mbrennwa/osmcdoc/figures/osmc_cabinet_open_damping.pdf

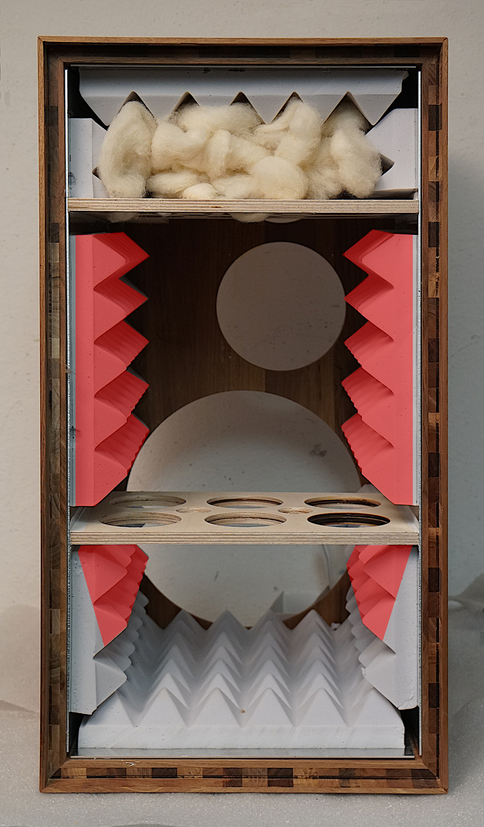
[picture p18: page 1]
