mbrennwa/osmcdoc/plots/osmc_analysis/data_filter_transfer_EL20190303/lowpass_inductor_positions.png

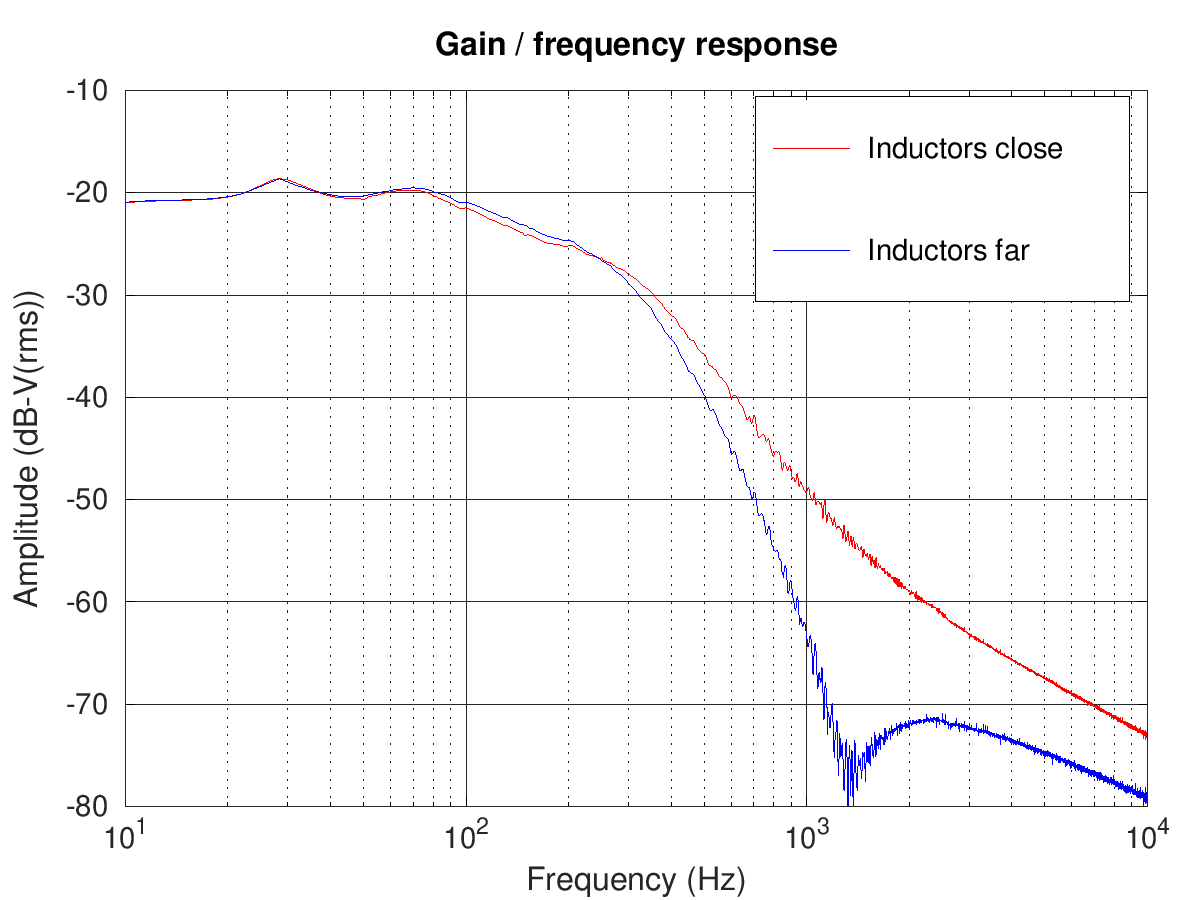
plots/osmc_analysis/data_filter_transfer_EL20190303/lowpass_inductor_positions.png
