mbrennwa/osmcdoc/plots/osmc_analysis/data_outdoor/outdoor_20181227/acoustic_mid.png

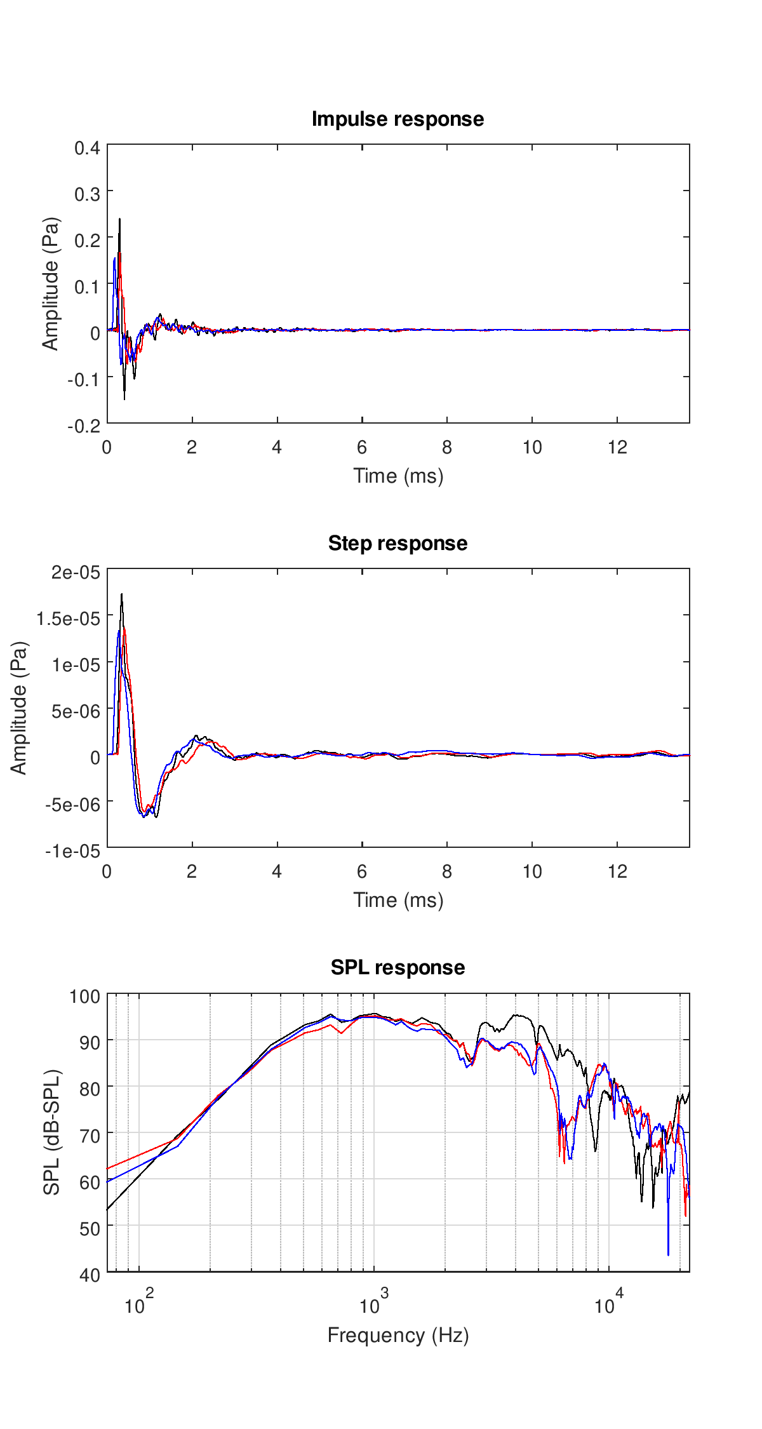
plots/osmc_analysis/data_outdoor/outdoor_20181227/acoustic_mid.png
