mbrennwa/osmcdoc/plots/osmc_analysis/data_outdoor/outdoor_20181227/acoustic_tweeter.png

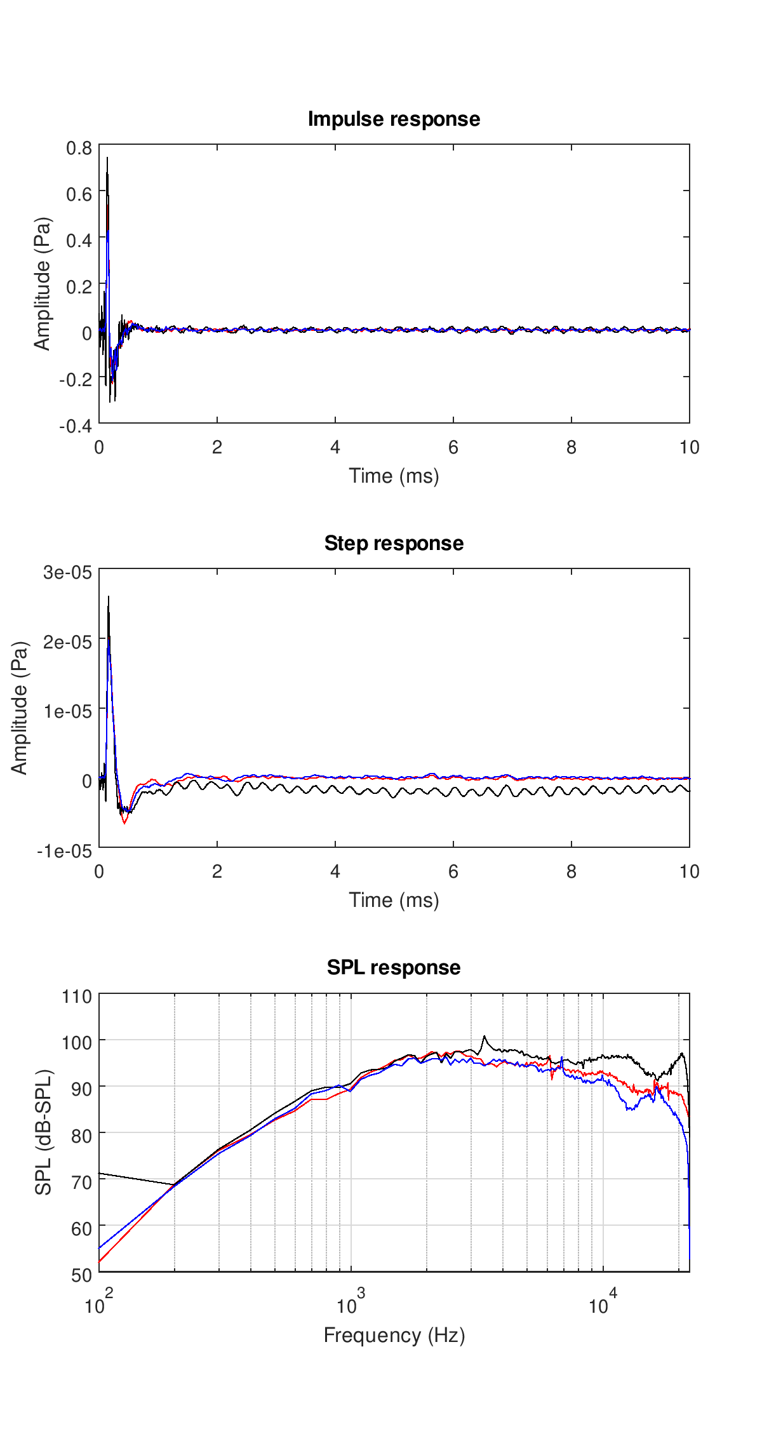
plots/osmc_analysis/data_outdoor/outdoor_20181227/acoustic_tweeter.png
