mbrennwa/osmcdoc/plots/osmc_analysis/data_outdoor/outdoor_20181227/acoustic_woofer.png

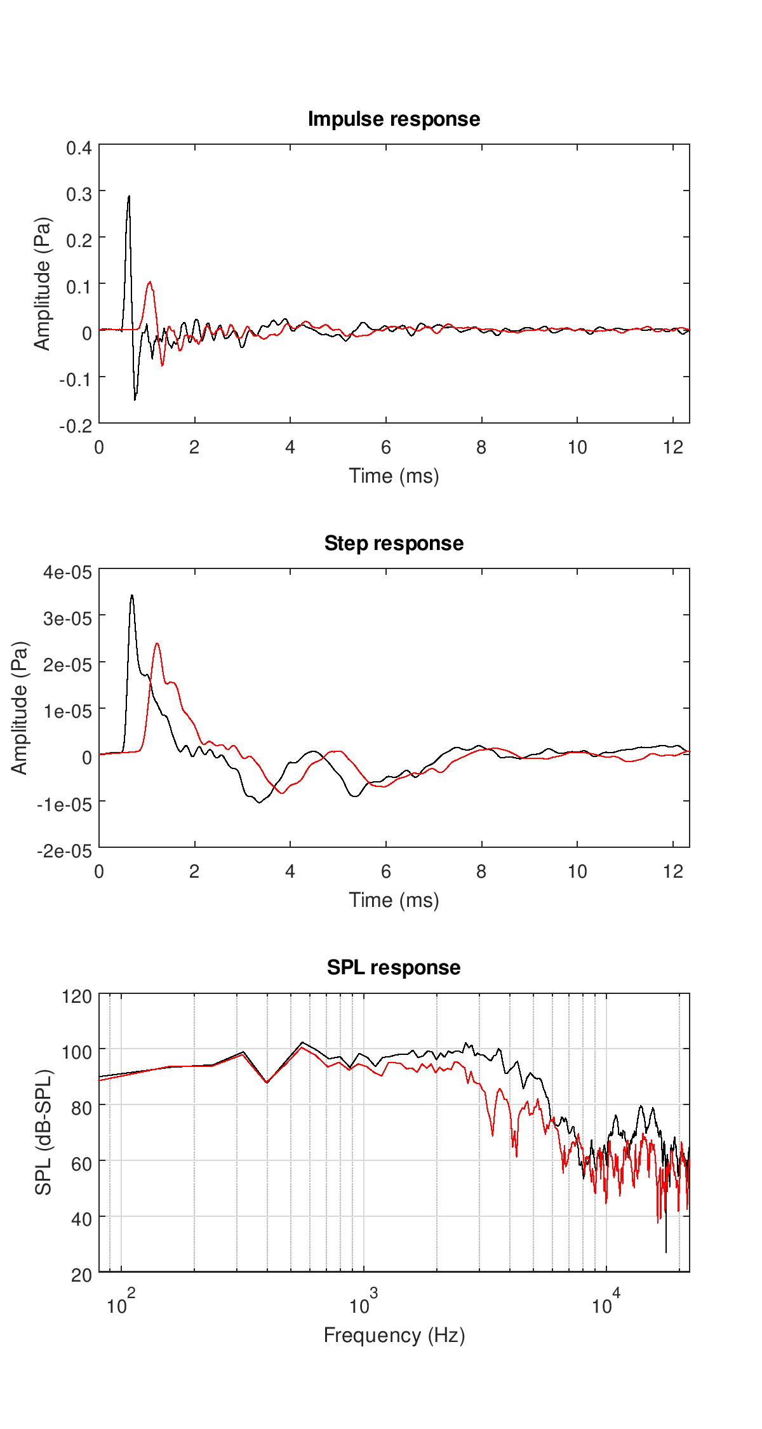
plots/osmc_analysis/data_outdoor/outdoor_20181227/acoustic_woofer.png
