mbrennwa/osmcdoc/plots/osmc_analysis/data_outdoor/outdoor_20181227/impedance.png

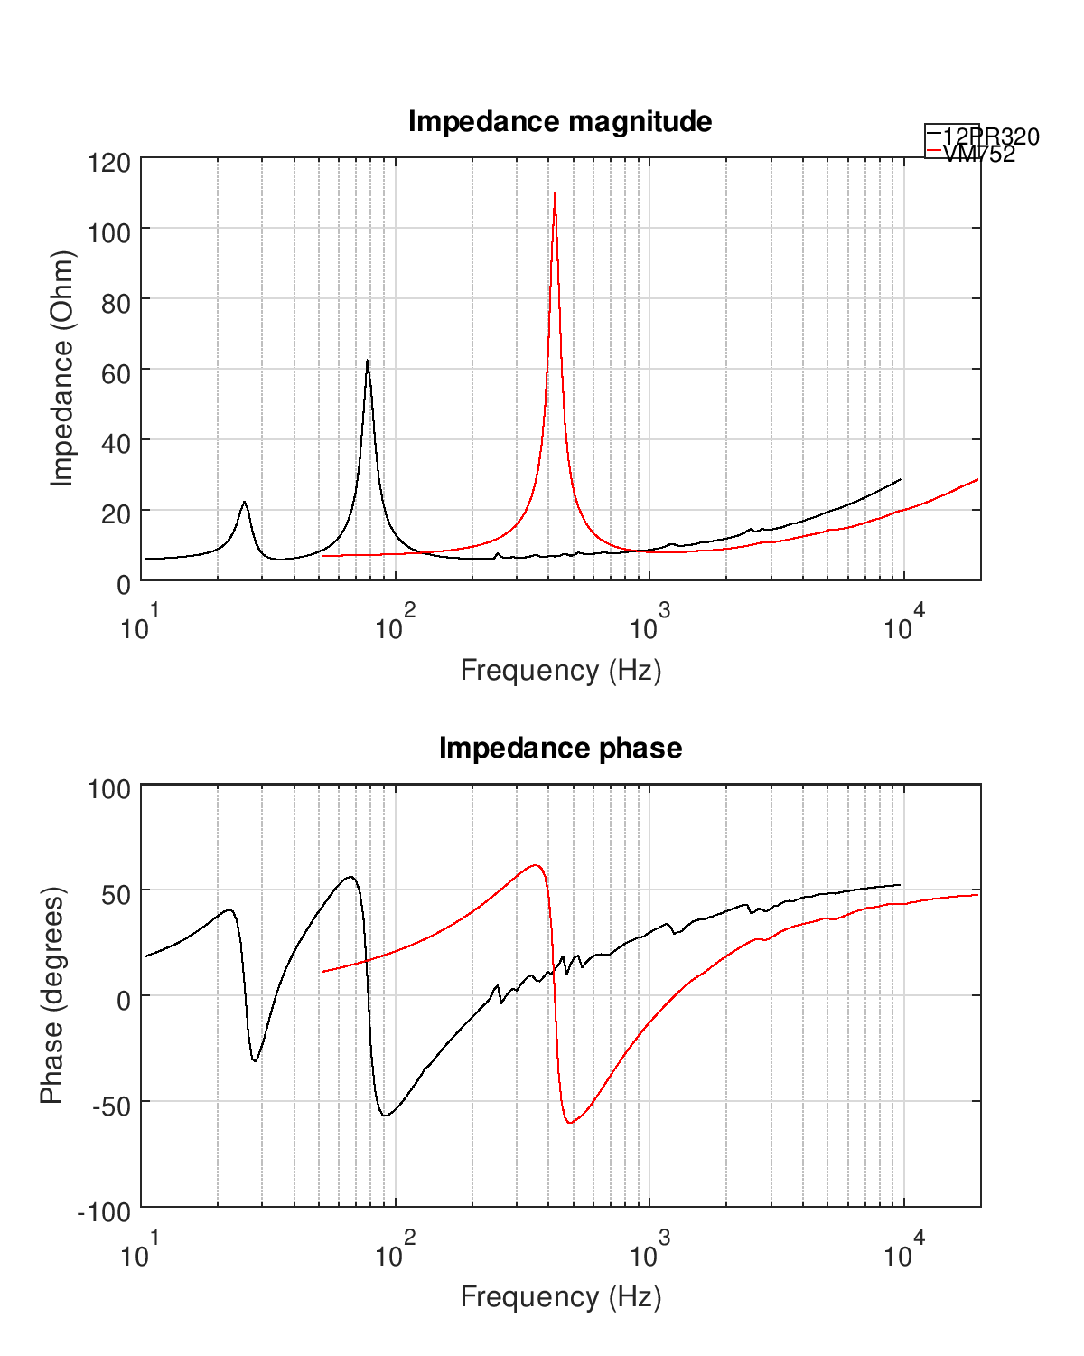
plots/osmc_analysis/data_outdoor/outdoor_20181227/impedance.png
