mbrennwa/osmcdoc/plots/osmc_analysis/data_outdoor/outdoor_20181227/PHOTOS/DSC08767.resized.JPG

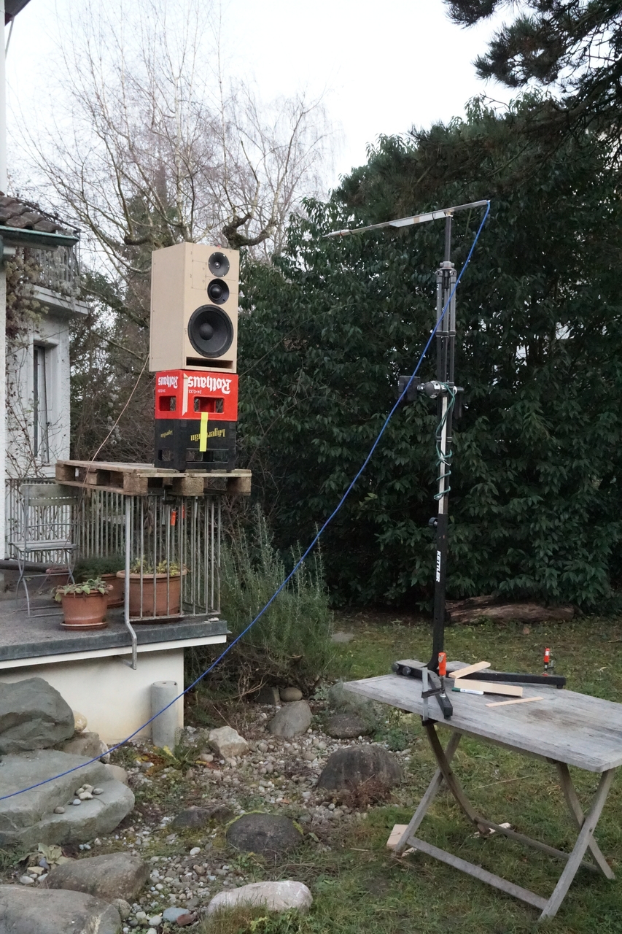
plots/osmc_analysis/data_outdoor/outdoor_20181227/PHOTOS/DSC08767.resized.JPG
