mbrennwa/osmcdoc/plots/osmc_analysis/data_outdoor/outdoor_20181228/acoustic.png

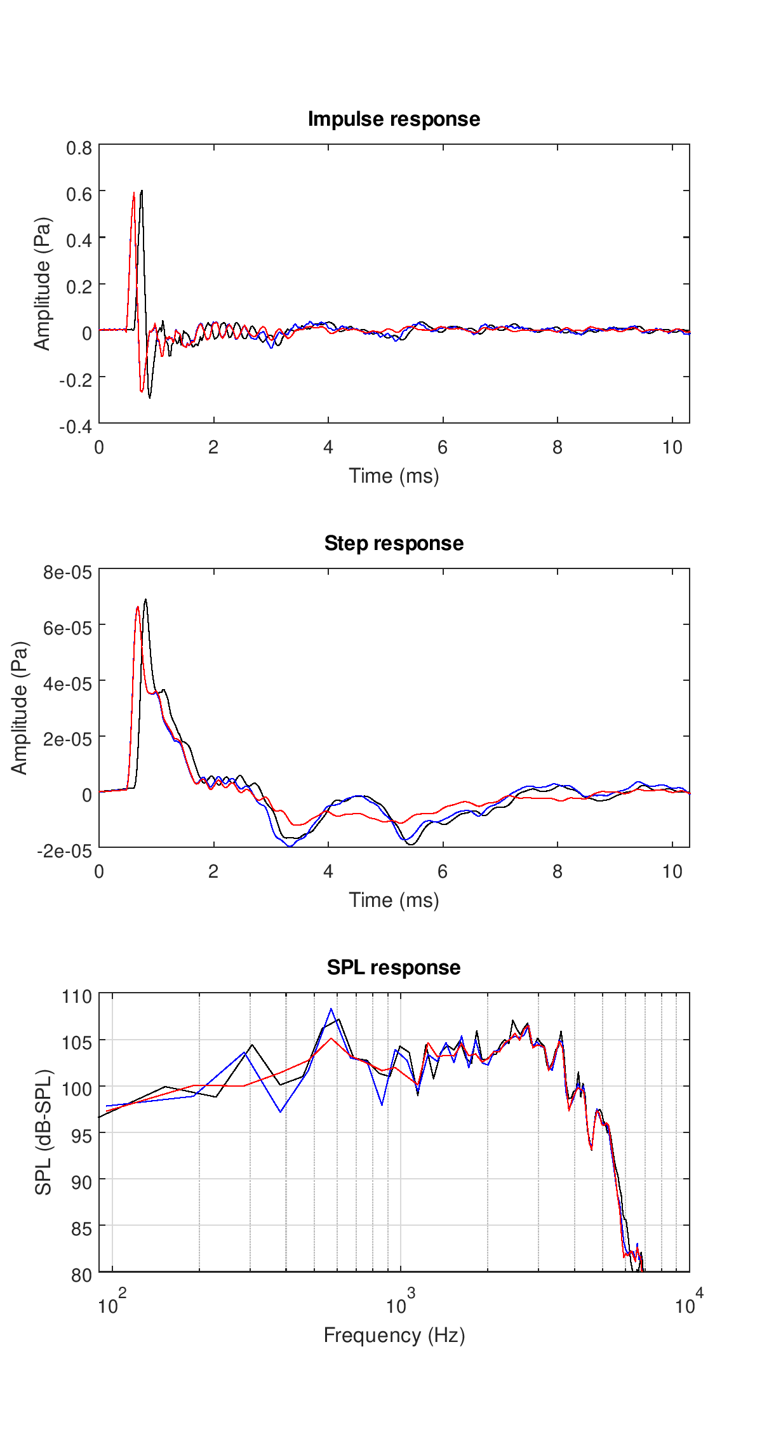
plots/osmc_analysis/data_outdoor/outdoor_20181228/acoustic.png
