mbrennwa/osmcdoc/plots/osmc_analysis/data_outdoor/outdoor_20181228/DSC08770.resized.JPG

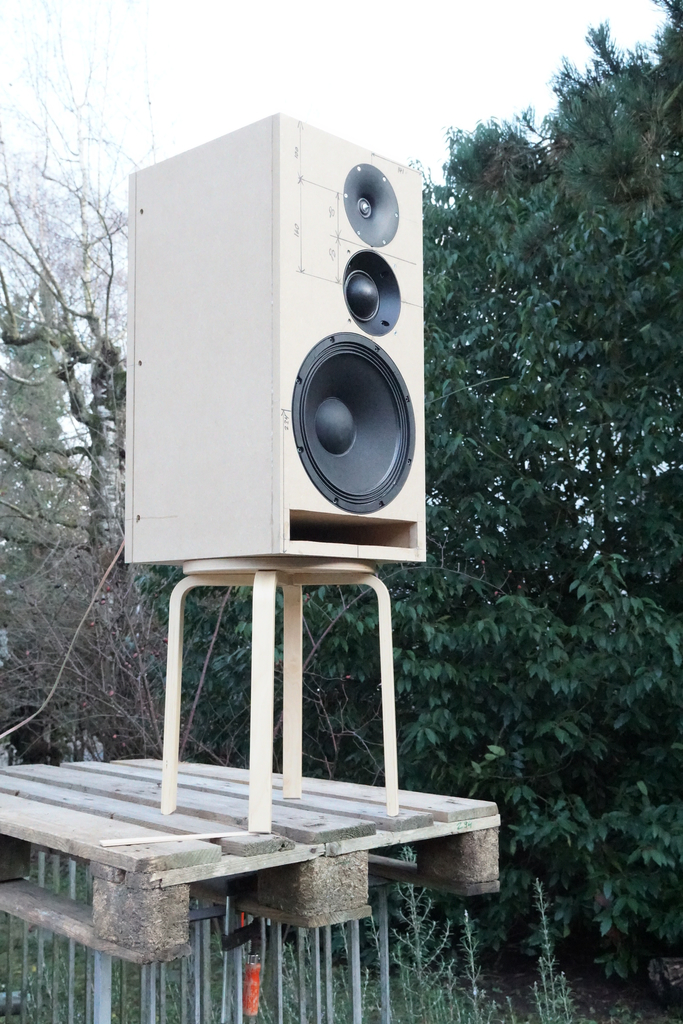
plots/osmc_analysis/data_outdoor/outdoor_20181228/DSC08770.resized.JPG
