mbrennwa/osmcdoc/other/5x.75 A_cnc_circle v3.step

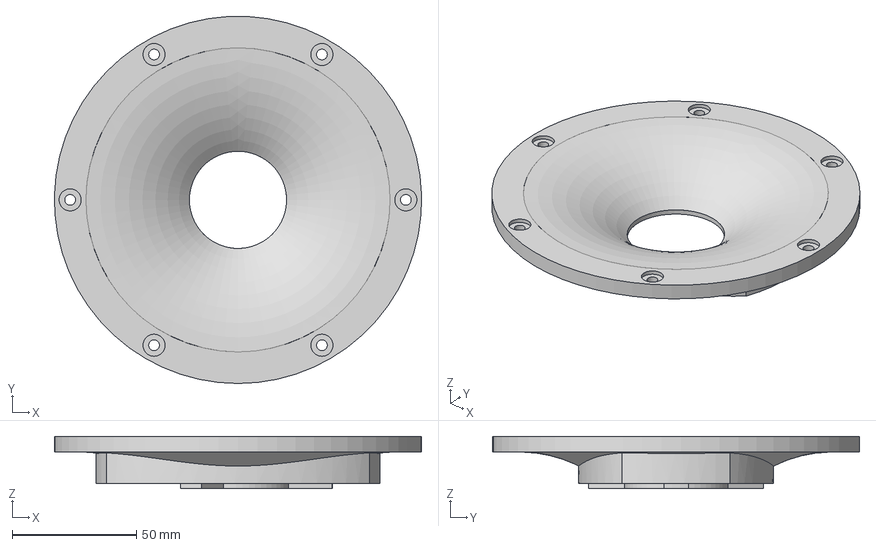
[picture p27: CAD file, 2025-02-12]
other/5x.75 A_cnc_circle v3.step
147.8 x 147.7 x 21.0 mm
