mbrennwa/osmcdoc/figures/impedance_curves_drivers-eps-converted-to.pdf

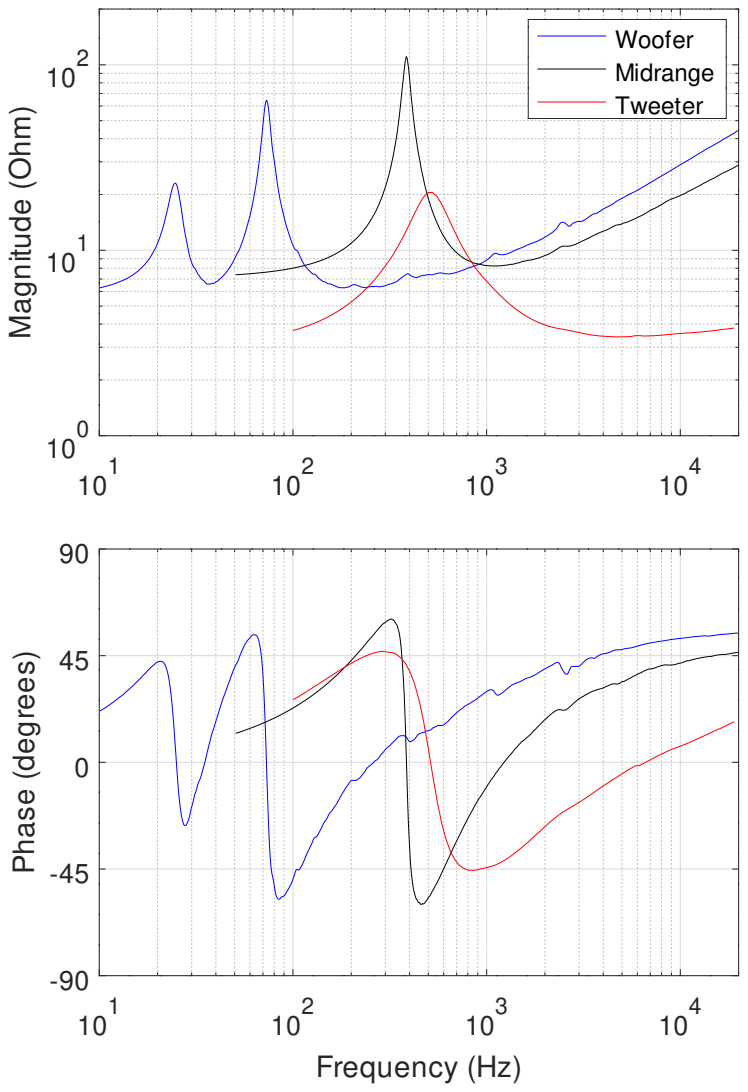
[picture p28: page 1]
Magnitude (Ohm); Tweeter; Phase (degrees); Frequency (Hz)

Woofer
Midrange
