mbrennwa/osmcdoc/figures/osmc_enclosure_20190823.pdf

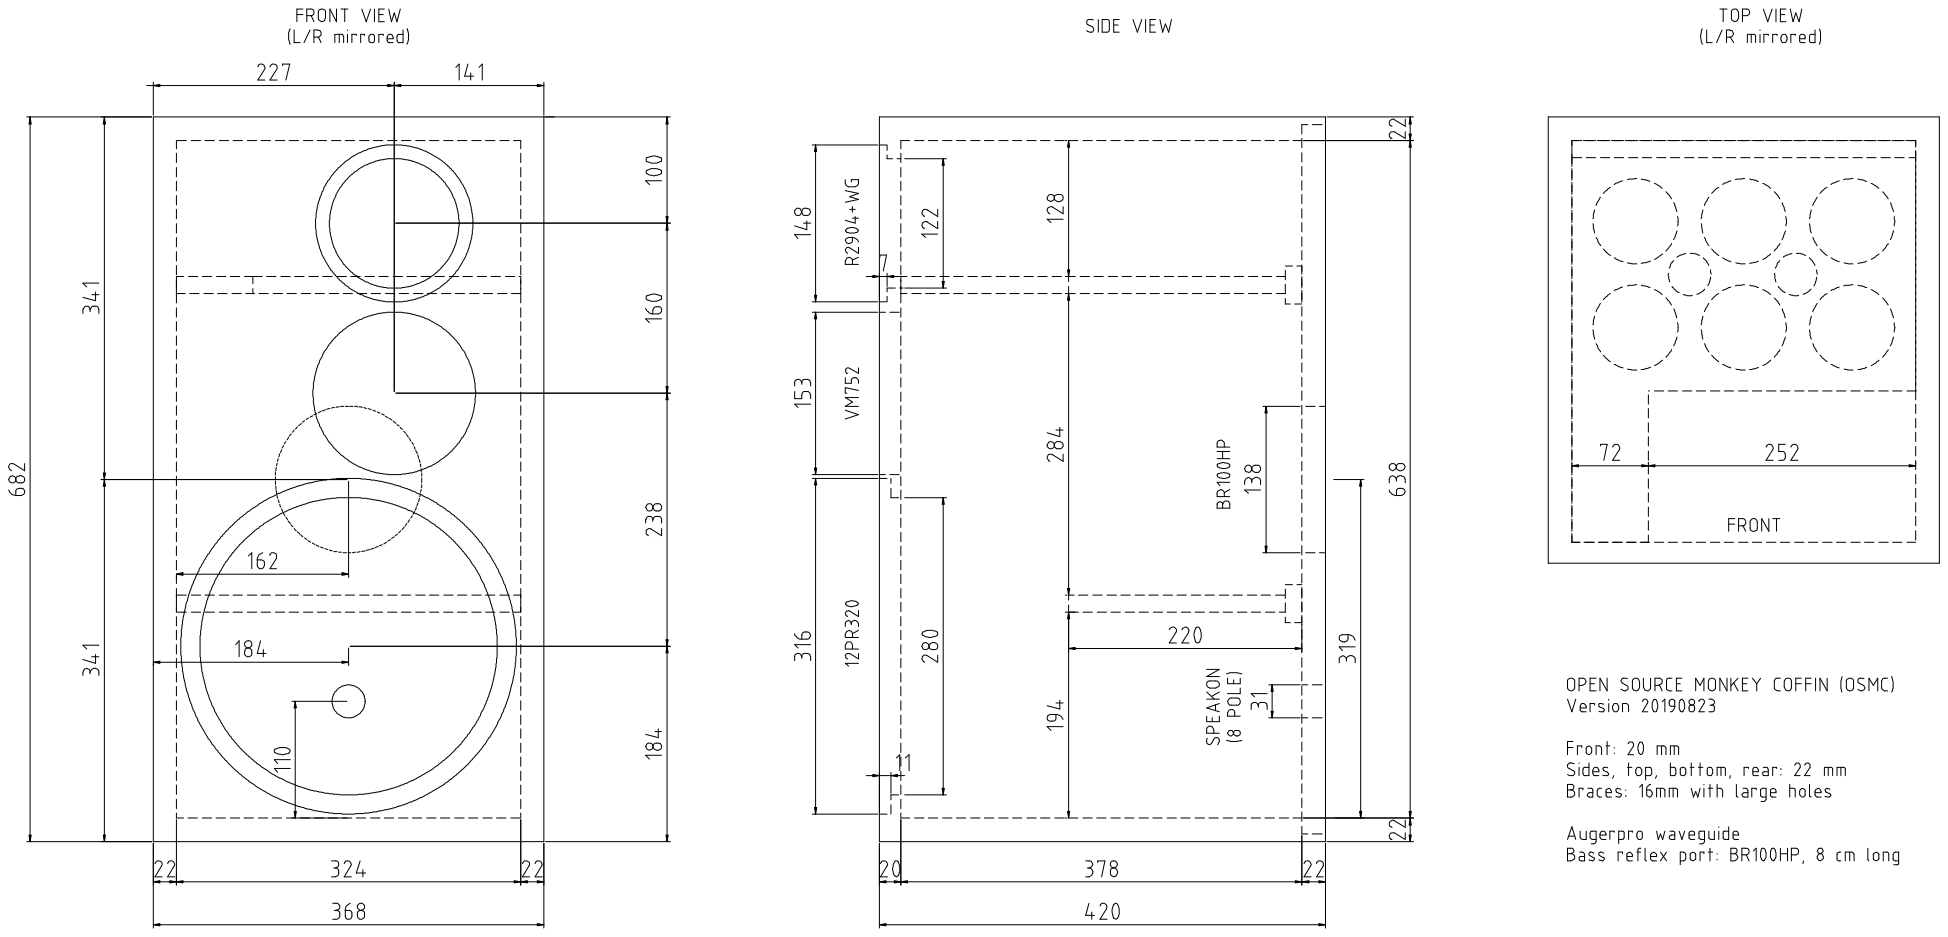
[picture p29: page 1]
