mbrennwa/osmcdoc/figures/osmc_EL_xover_schem.pdf

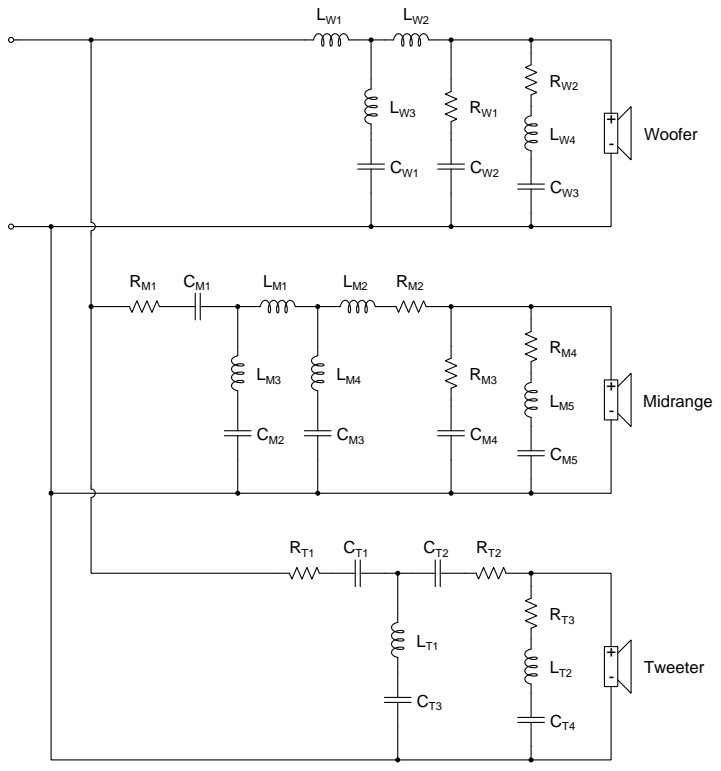
[picture p30: page 1]
Woofer; Midrange; Tweeter
