mbrennwa/osmcdoc/(commit log)

2019-04-28 added figure of driver impedance curves.
2019-12-09 added comments about power response
2020-01-03 updated description of damping materials
2020-06-13 fixed typo(?) in L(M1) resistance spec, fixed cosmetic issues.
2020-06-24 added reference and photo of waveguide/tweeter clamp.
